f2re/hand-draw-esp/docs/START_HERE.md

# Полный маршрут: от закупки до первого рисунка

Эта инструкция задаёт обязательные шлюзы работ. Не переходите к следующему этапу, пока не выполнены критерии приёмки предыдущего. Конструкция рассчитана на MKS DLC32 V2.1, два NEMA17, TMC2209, ремни GT2, направляющие MGN12H и позиционный MG90S.

Проект находится на стадии инженерного прототипа. Программная часть проверяется автоматически; физическая механика должна быть подтверждена измерениями и контрольной сборкой.

## 0. Зафиксированная конфигурация

| Параметр | Значение |
|---|---|
| Управляемое поле | 225 × 315 мм |
| Лист | A4 210 × 297 мм, неподвижный, портретная установка |
| Ось Y | MGN12H 450 мм, две каретки, центры 52 мм |
| Ось X | профиль 2020 длиной 350 мм + MGN12H 300 мм |
| Передача | GT2 6 мм, шкивы 20T |
| Двигатели | 2 × одинаковых NEMA17, 1,8°, известный ток фазы |
| Контроллер | MKS DLC32 V2.1, ESP32-WROOM |
| Драйверы | одинаковые TMC2209 StepStick, автономный STEP/DIR |
| Подъём пера | MG90S 180°, виртуальная ось Z |
| Питание | 12 В / 5 А; отдельные 5,0 В для MG90S |

Изменение шкива, микрошагов, поля, направляющей, расстояния кареток или платы требует обновления CAD, повторной проверки и при необходимости изменения `firmware/fluidnc/config.yaml`.

Прямой альбомный лист не помещается по X=225 мм. Альбомное задание допускается только после реализации и проверки программного поворота траектории на портретно установленном листе.

## 1. Проверка GitHub-проекта

После получения или обновления репозитория:

```bash
python3 scripts/setup_project.py
npm test
```

CAD без OpenSCAD:

```bash
python3 scripts/validate_cad.py
```

При установленном OpenSCAD:

```bash
python3 scripts/validate_cad.py --strict --render-all
```

Критерий завершения:

- `npm test` завершается успешно;
- CAD-валидатор подтверждает физический ход;
- OpenSCAD компилирует сборку и все печатные детали;
- отсутствуют ошибки `assert`.

## 2. Шлюз A — закупка критичных деталей

Откройте [`hardware/BOM.md`](../hardware/BOM.md). На первом этапе заказываются только компоненты, определяющие геометрию и настройку приводов:

- MGN12H 450 мм с двумя каретками;
- MGN12H 300 мм с одной кареткой;
- профиль 2020 длиной 350 мм, паз 6;
- два одинаковых NEMA17 с паспортным током;
- три одинаковых TMC2209, включая запасной;
- два позиционных MG90S;
- шкивы, ролики, ремень и 625;
- одинаковые концевики COM/NO/NC;
- MKS DLC32 с зафиксированной подревизией.

Не заказывайте полный набор нестандартного крепежа и не печатайте весь пластик до измерения.

Критерий завершения:

- Y-рельс действительно имеет две каретки;
- двигатели одной модели;
- драйверы одной ревизии;
- MG90S позиционный, а не непрерывный;
- подревизия MKS DLC32 записана;
- критичные компоненты не имеют механических повреждений.

## 3. Шлюз B — измерение

1. Сделайте копию `hardware/measurements.example.csv` под именем `hardware/measurements.csv`.
2. Выполните [`hardware/MEASUREMENTS.md`](../hardware/MEASUREMENTS.md).
3. Зафиксируйте точные артикулы, номиналы и фактические размеры.
4. Перенесите принятые размеры в [`hardware/cad/component_dimensions.scad`](../hardware/cad/component_dimensions.scad).
5. Повторно запустите CAD-валидатор.

Обязательно измерить:

- длины и сетки отверстий MGN12H;
- положение крайних отверстий рельсов;
- профиль и T-гайки;
- NEMA17 и ток фазы;
- ревизию, Rsense и Vref TMC2209;
- корпус, уши и рог MG90S;
- ролики, шкивы и подшипник 625;
- концевики;
- ручку и пружину;
- отверстия конкретной платы MKS DLC32.

Критерий завершения:

- все строки критичных компонентов имеют статус;
- нет размеров, принятых только по названию карточки товара;
- `validate_cad.py` подтверждает ход не меньше 225 × 315 мм;
- режим `motion_envelope` не показывает очевидных столкновений.

## 4. Шлюз C — контрольная 3D-печать

Следуйте [`hardware/PRINTING.md`](../hardware/PRINTING.md). Сначала печатаются:

1. `fit_coupon`;
2. одно `beam_saddle`;
3. `pen_slider`;
4. тест корпуса пера;
5. один `belt_clamp`;
6. `servo_bracket`;
7. один `endstop`.

Критерии завершения:

- профиль входит рукой и фиксируется без раскалывания седла;
- ползун движется свободно без заметного качания;
- M3/M4/M5 соответствуют принятому зазору;
- ремень удерживается без повреждения корда;
- MG90S устанавливается без изгиба корпуса;
- концевик совпадает с фактическими отверстиями.

После корректировки параметров повторно выполнить OpenSCAD-компиляцию всех деталей.

## 5. Шлюз D — сухая механическая сборка

Выполняйте [`hardware/ASSEMBLY.md`](../hardware/ASSEMBLY.md):

1. плоское основание;
2. рельс Y и две каретки;
3. пластина Y;
4. два седла и балка 2020;
5. рельс X;
6. каретка пера;
7. опорный ролик свободного конца;
8. концевики;
9. проверка кабельных зон.

На этом этапе ремни и двигатели ещё не должны маскировать механическое закусывание.

Критерий завершения:

- обе оси проходят полный ход рукой;
- профиль остаётся перпендикулярным Y;
- два седла не изгибают профиль;
- опорный ролик только поддерживает балку;
- каретка пера не сталкивается с кронштейнами;
- лист и его зажимы находятся вне опасных траекторий.

## 6. Шлюз E — приводы

1. Установите осевые кронштейны X и Y; они не взаимозаменяемы.
2. Установите шкивы и ролики в одной плоскости.
3. Закрепите ремни согласованными зажимами с шагом 18 мм.
4. Натяните ремни только до исчезновения провиса.
5. Найдите пары обмоток двигателей мультиметром.
6. Установите микрошаг 1/16 по схеме конкретной ревизии TMC2209.
7. Рассчитайте начальный Vref по точной схеме драйвера и току двигателя.

Нельзя применять формулу Vref одной ревизии TMC2209 к неизвестному модулю.

Критерий завершения:

- ручное вращение валов не выявляет тугих зон;
- ремни не трутся о борта;
- шкивы закреплены на D-срезе;
- начальные значения тока документированы;
- радиаторы установлены.

## 7. Электрика

Используйте [`hardware/WIRING.md`](../hardware/WIRING.md) и [`docs/images/wiring.svg`](images/wiring.svg).

Порядок:

1. 12 В и USB отключены.
2. Проверена ориентация TMC2209.
3. DC/DC настроен мультиметром на 5,0 В без сервопривода.
4. Объединены GND платы, DC/DC и MG90S.
5. MG90S получает питание только от DC/DC.
6. Концевики подключены через COM+NC.
7. Предохранитель установлен возле входа 12 В.
8. Жгуты имеют разгрузку на полном ходе.

Критерий завершения:

- между +12 В и GND нет короткого замыкания;
- линия MG90S имеет 5,0 В без заметной просадки;
- провода промаркированы;
- доступно аппаратное отключение 12 В.

## 8. Первичная прошивка ESP32

Следуйте [`firmware/fluidnc/INSTALL.md`](../firmware/fluidnc/INSTALL.md). На первом этапе подключается только USB; 12 В, двигатели и MG90S отключены.

```bash
python3 scripts/install_fluidnc.py
python3 scripts/install_fluidnc.py --flash
```

Затем подготовьте проект:

```bash
python3 scripts/build_webui.py
python3 scripts/prepare_controller_bundle.py
```

Загрузите WebUI:

```bash
python3 scripts/deploy_webui.py handdraw.local
```

Конфигурацию передавайте отдельно и только после проверки платы:

```bash
python3 scripts/deploy_webui.py handdraw.local --with-config
```

После перезагрузки прочитайте полный журнал. Нельзя продолжать при сообщениях:

```text
Ignored key
Pin is already used
ERR
Guru Meditation
```

## 9. Первый пуск без ручки

1. Снимите 12 В.
2. Установите драйверы и подключите двигатели.
3. Отведите каретки от упоров.
4. Включите питание с готовностью немедленно его снять.
5. Проверьте `$Limits`, нажимая каждый концевик рукой.
6. Выполните перемещения X/Y по 1–5 мм.
7. Исправьте направление в конфигурации при снятом питании.
8. Запустите `gcode/servo_test.gcode` без пишущего инструмента.
9. Проверьте homing `$H` несколько раз.
10. Откройте WebUI с ESP32 и убедитесь, что состояние и координаты обновляются.

Критерий завершения:

- оси движутся в ожидаемом направлении;
- правильный концевик останавливает правильную ось;
- ни одна каретка не ударяется в упор;
- MG90S не упирается и не нагревается;
- двигатели и драйверы не перегреваются на малых перемещениях;
- WebUI определяет завершение homing в текущем сеансе.

## 10. Калибровка, профиль инструмента и первый рисунок

Следуйте [`docs/CALIBRATION.md`](CALIBRATION.md):

1. квадрат 100 × 100 мм;
2. измерение сторон;
3. измерение диагоналей;
4. устранение механического перекоса;
5. корректировка `steps_per_mm`;
6. повторный проход по линии;
7. рамка A4 с поднятым инструментом;
8. установка линера или шариковой ручки;
9. подбор пружины и крайних положений Z;
10. текстовый пресет «Аккуратная запись» и простой SVG.

Для первого рисунка используйте линер: это наиболее предсказуемый профиль. После успешного задания отдельно калибруйте гелевую ручку, карандаш, маркер и перо с тушью. Смена инструмента требует нового теста подъёма и обводки рамки.

Рабочий поток WebUI:

1. сформировать макет и устранить предупреждения;
2. выбрать профиль реального инструмента;
3. подключить FluidNC и выполнить homing;
4. выполнить тест пера и подтвердить результат;
5. закрепить лист;
6. обвести габарит с поднятым пером;
7. записать и проверить файл на SD;
8. запустить под постоянным наблюдением.

Подробно: [`docs/WEB_INTERFACE.md`](WEB_INTERFACE.md) и [`docs/FIRMWARE_AND_GCODE.md`](FIRMWARE_AND_GCODE.md).

Целевые критерии первой рабочей версии:

- сторона 100 мм: отклонение не более ±0,3 мм;
- разность диагоналей: не более 0,5 мм;
- повторная линия расходится не более чем на 0,3 мм;
- перо полностью отрывается;
- бумага не продавливается;
- отсутствуют пропуски шагов;
- после длительного задания температуры остаются допустимыми.

## 11. Финальная конфигурация безопасности

После устойчивого homing:

- включить обязательный homing перед заданиями;
- определить режим аппаратных ограничений;
- зафиксировать финальный Vref;
- сохранить итоговый `config.yaml`;
- приложить журнал загрузки;
- проверить аппаратное снятие 12 В.

Программная кнопка остановки не заменяет аппаратный разрыв питания.

## 12. Восстановление

При некорректной работе:

1. снять 12 В;
2. отключить двигатели и MG90S;
3. подключить только USB;
4. при необходимости выполнить штатный `erase`;
5. повторно установить FluidNC;
6. проверить чистую прошивку;
7. загрузить WebUI;
8. конфигурацию загрузить последней;
9. повторить ввод с первого пуска без ручки.

## Карта документации

- [`docs/CAD_REWORK_PLAN.md`](CAD_REWORK_PLAN.md) — план доведения механики;
- [`hardware/BOM.md`](../hardware/BOM.md) — закупочные шлюзы;
- [`hardware/MEASUREMENTS.md`](../hardware/MEASUREMENTS.md) — измерение;
- [`hardware/cad/README.md`](../hardware/cad/README.md) — CAD и экспорт;
- [`hardware/PRINTING.md`](../hardware/PRINTING.md) — 3D-печать;
- [`hardware/ASSEMBLY.md`](../hardware/ASSEMBLY.md) — механика;
- [`hardware/WIRING.md`](../hardware/WIRING.md) — электрика;
- [`firmware/fluidnc/INSTALL.md`](../firmware/fluidnc/INSTALL.md) — прошивка ESP32;
- [`docs/DEPLOYMENT.md`](DEPLOYMENT.md) — WebUI и конфигурация;
- [`docs/WEB_INTERFACE.md`](WEB_INTERFACE.md) — работа оператора;
- [`docs/FIRMWARE_AND_GCODE.md`](FIRMWARE_AND_GCODE.md) — генерация G-code и профили инструментов;
- [`docs/ART_DIRECTION.md`](ART_DIRECTION.md) — принципы интерфейса;
- [`docs/CALIBRATION.md`](CALIBRATION.md) — калибровка;
- [`docs/SAFETY.md`](SAFETY.md) — безопасность.

## Интерактивный ввод в эксплуатацию

После электрической проверки откройте [`COMMISSIONING.md`](COMMISSIONING.md), создайте профиль своего станка, опросите FluidNC, проверьте направления и концевики, затем рассчитайте steps/mm.
