f2re/hand-draw-esp/docs/FIRMWARE_AND_GCODE.md

# Прошивка, генерация G-code и профили инструментов

Проверенная версия FluidNC закреплена в `firmware/fluidnc/fluidnc-lock.json`. Установщик использует этот тег по умолчанию; `--latest` разрешён только как осознанная проверка нового выпуска.

## Может ли ESP32 генерировать G-code

Технически ESP32 способен сформировать простой G-code из заранее известных координат, короткого текста или параметрической фигуры. Однако обработка произвольного SVG, фотографии, штриховки и пользовательского шрифта на самом контроллере конкурировала бы с памятью, сетевым стеком и задачами реального времени.

В HandDraw ESP принят более надёжный вариант:

1. ESP32 хранит и раздаёт автономный WebUI.
2. JavaScript выполняется в браузере телефона или компьютера.
3. Браузер преобразует текст, SVG или растр в полилинии и G-code.
4. Готовый файл записывается на SD-карту ESP32.
5. FluidNC планирует движение и выполняет файл.

Поэтому система работает без облака и интернета, но тяжёлая геометрия не выполняется внутри задачи управления двигателями. Для пользователя это выглядит как единое устройство: страница открывается с контроллера и работает в его локальной сети или точке доступа.

Создание отдельной серверной прошивки-генератора не требуется и не входит в проект. Это позволило сохранить официальный FluidNC вместо собственного трудно поддерживаемого форка.

## Разделение ответственности

FluidNC отвечает за:

- STEP/DIR и планировщик движения;
- ограничения скорости и ускорения;
- homing и программные границы;
- RC-servo как ось Z;
- выполнение G-code с SD-карты;
- realtime-команды паузы, продолжения и сброса;
- HTTP, WebDAV и WebSocket.

WebUI отвечает за:

- раскладку однолинейного текста;
- воспроизводимую вариативность почерка;
- импорт SVG;
- контуры, одинарную и перекрёстную штриховку, комикс-режим;
- поворот альбомного макета в физически портретный лист;
- оптимизацию порядка штрихов;
- анализ длины линий, подъёмов пера и времени;
- подготовку и проверку файла перед запуском.

## Профили пишущих инструментов

Значения ниже являются безопасными стартовыми параметрами, а не универсальными физическими нормами. Они находятся ниже пределов осей в `config.yaml` и должны уточняться на конкретной механике и бумаге.

| Профиль | Рисование | Холостой ход | Контакт / подъём | Особенность |
|---|---:|---:|---:|---|
| Линер | 1200 мм/мин | 3600 мм/мин | 0,10 / 0,08 с | универсальный тонкий штрих |
| Гелевая ручка | 850 | 2800 | 0,16 / 0,12 с | меньше скорость из-за насыщенной пасты |
| Шариковая ручка | 1050 | 3400 | 0,08 / 0,06 с | умеренный нажим, универсальный режим |
| Карандаш | 760 | 2700 | 0,05 / 0,05 с | перекрёстная штриховка, допустим повтор |
| Перо с тушью | 520 | 2100 | 0,24 / 0,18 с | только направленные штрихи, короткие задания |
| Маркер | 650 | 2300 | 0,14 / 0,12 с | редкая штриховка, без плотной заливки |

Профиль задаёт:

- скорость линии и перехода;
- выдержку после опускания и подъёма;
- возможность разворачивать направление штриха при оптимизации;
- рекомендуемую длину непрерывной линии;
- режим и плотность растра;
- начальный текстовый пресет;
- толщину линии в предпросмотре.

### Что профиль не может задать программно

В принятом держателе MG90S только поднимает ползун. Нажим создаётся пружиной, массой ползунка и положением инструмента. Поэтому профиль не заменяет механическую настройку:

- линеру и перу нужен минимальный нажим;
- шариковой ручке обычно требуется больше;
- карандаш должен писать без изгиба балки и поломки грифеля;
- маркер не должен продавливать и пропитывать лист.

Значения `Z0` и `Z5` задают крайние положения механизма подъёма. После смены геометрически другого инструмента требуется выполнить тест пера.

## Направленное перо с тушью

Перо отличается от шариковой ручки:

- обратный ход может менять толщину, цепляться за бумагу или разбрызгивать тушь;
- слишком длинная линия может закончиться без туши;
- частые мелкие штрихи вызывают лишние касания;
- плотная штриховка деформирует бумагу.

Поэтому профиль пера:

- запрещает разворот штрихов при оптимизации;
- по умолчанию выбирает контуры;
- предупреждает о линии длиннее 120 мм;
- при повторном проходе поднимает перо, возвращается к началу и снова идёт вперёд;
- не предполагает автоматического макания.

## Структура G-code

Генератор использует:

```gcode
G21        ; миллиметры
G90        ; абсолютные координаты
G94        ; подача в мм/мин
G0 Z5      ; перо вверх
G1 X… Y… F… ; переход с ограниченной скоростью профиля
G0 Z0      ; перо вниз
G4 P…      ; выдержка контакта
G1 X… Y… F… ; рисование
```

Перед запуском проверяются:

- исходные координаты без подмены `NaN`/`Infinity` нулями;
- границы портретного A4;
- положение листа относительно машинного нуля и итоговое поле 225 × 315 мм;
- положительные скорости;
- корректный диапазон пера и попадание обоих положений в Z 0…5 мм;
- число точек и подъёмов;
- длительность;
- длинные и слишком короткие штрихи;
- особенности выбранного инструмента.

Имя задания транслитерируется в переносимый ASCII-вариант, чтобы избежать проблем файловой системы и команд `$SD/Run`.

### Координаты листа и станка

Геометрия текста, SVG и растра хранится в координатах листа. Перед выпуском G-code к ней добавляется положение физического листа относительно машинного нуля. Для центрированного A4 в поле 225 × 315 мм используются начальные значения:

```text
X = 7,5 мм
Y = 9,0 мм
```

Поля `Лист от нуля X/Y` находятся в диагностическом разделе WebUI. Проверочная рамка и основное задание используют одни и те же смещения. Если после установки углового упора значения отличаются, оператор вводит фактические размеры; интерфейс блокирует задание, выходящее за машинное поле.

### Очередь команд и запись на SD

Обычные команды отправляются по одной и считаются завершёнными только после ответа `ok`. `error`, `ALARM`, разрыв WebSocket или тайм-аут прекращают текущую последовательность. Realtime-команды `?`, `!`, `~` и `Ctrl-X` остаются вне очереди.

G-code сначала записывается во временный файл, читается обратно и сравнивается побайтово. Затем WebUI пытается завершить запись через WebDAV `MOVE`; если контроллер не поддерживает этот метод, выполняется проверенная запись итогового файла и удаление временного. Простое совпадение размера больше не считается достаточной проверкой.

## Логика безопасного запуска

WebUI не позволяет запустить задание, пока не выполнены этапы:

1. макет находится в пределах листа;
2. FluidNC подключён и находится в допустимом состоянии;
3. выполнен homing в текущем сеансе;
4. отправлен тест пера и оператор подтвердил результат;
5. подтверждено крепление бумаги;
6. выполнена обводка габарита с поднятым пером и оператор подтвердил отсутствие столкновений;
7. G-code записан на SD и прочитан обратно;
8. в последнем диалоге подтверждено наблюдение за станком.

Смена макета или профиля инструмента сбрасывает относящиеся к нему подтверждения.

## Конфигурация FluidNC

`firmware/fluidnc/config.yaml` содержит консервативные пределы:

| Ось | Максимальная скорость | Ускорение |
|---|---:|---:|
| X | 4800 мм/мин | 180 мм/с² |
| Y | 4200 мм/мин | 140 мм/с² |
| Z-servo | 240 мм/мин | 80 мм/с² |

Профили инструментов используют меньшие скорости. Пределы контроллера являются последней защитой от ошибочно завышенного значения в интерфейсе.

### Ввод в эксплуатацию и рабочий режим

В репозитории находятся два профиля:

- `config.yaml` — наладочный: `must_home: false`, `hard_limits: false`;
- `config-production.yaml` — рабочий: `must_home: true`, `hard_limits: true`.

Наладочный профиль позволяет проверить направления перемещениями 1–5 мм. WebUI всё равно не разрешает запуск файла без homing в текущем сеансе. Рабочий профиль устанавливается только после проверки полярности обоих NC-концевиков и нескольких устойчивых циклов `$H`; включать его вслепую нельзя.

## Ограничения

- браузер нельзя закрывать во время подготовки и наблюдения, однако уже запущенный SD-файл выполняется FluidNC независимо от страницы;
- программный `Стоп` не заменяет аппаратное отключение 12 В;
- профиль не определяет реальный нажим;
- оценка времени учитывает длины и выдержки, но не моделирует полностью разгон на каждом сегменте;
- для пера с тушью автоматическое пополнение туши не реализовано;
- сложный растр требует разрежения, иначе задание будет долгим и создаст тысячи подъёмов.

## Профиль конкретного станка

Файл `.handdraw-machine.json` отделяет параметры конкретной сборки от общих профилей ручки или пера. В нём хранятся геометрия листа, steps/mm, пределы Z, сведения о контроллере и аппаратные подтверждения. Профиль не переписывает YAML автоматически: после измерения оператор переносит экспортированный фрагмент в обе конфигурации и повторяет контрольный рисунок.
