f2re/hand-draw-esp/docs/WEB_INTERFACE.md

# Веб-интерфейс оператора

## Назначение

WebUI хранится на ESP32 и открывается в обычном браузере. Интернет и внешние сервисы не нужны. Телефон или компьютер выполняет геометрические расчёты, а FluidNC остаётся ответственным за движение.

Основной поток состоит из трёх этапов: **Макет → Инструмент → Станок**. Лист с предпросмотром остаётся рядом на широком экране и переносится ниже элементов управления на телефоне.

## 1. Макет

### Текст

Встроены пресеты:

- живой почерк;
- аккуратная запись;
- технический текст;
- комикс;
- карандашный эскиз;
- перо.

По умолчанию используется однолинейный рукописный вариант, построенный из нескольких воспроизводимых начертаний. При одинаковом тексте, параметрах и зерне результат повторяется.

Основные параметры — текст, шрифт, высота букв и выравнивание. Точная настройка скрыта в раскрываемом блоке и включает ширину, интервалы, масштаб строчных, наклон и небольшую вариативность положения.

### SVG

Поддерживаются `path`, линии, ломаные, многоугольники, прямоугольники, окружности, эллипсы и `use`. Итоговая геометрия сэмплируется средствами браузера и упрощается с заданным допуском.

SVG-текст следует предварительно преобразовать в кривые либо набрать во встроенном редакторе текста.

### Растровый рисунок

Доступны четыре режима:

- одинарная штриховка;
- перекрёстная штриховка;
- контуры;
- комикс — контур и разреженные тени.

Можно изменять порог темноты, шаг, угол, детализацию контура и инверсию. Перед обработкой большое изображение уменьшается до рабочего размера, чтобы телефон не создавал чрезмерное число точек.

### Лист

Физически лист A4 устанавливается портретно. Альбомный макет автоматически поворачивается в это поле. Независимые поля задаются в миллиметрах.

Макет хранится в координатах бумаги, а G-code формируется в координатах станка. В разделе «Ручное управление и диагностика» задаётся положение листа от машинного нуля: номинально X 7,5 и Y 9 мм для центрированного A4 в поле 225 × 315 мм. Эти же значения применяются к проверочной рамке.

Предпросмотр, проверка границ и G-code используют один массив полилиний. Красное состояние означает, что запуск недопустим.

## 2. Инструмент

Профили доступны одной группой выбора:

- линер;
- гелевая ручка;
- шариковая ручка;
- карандаш;
- перо с тушью;
- маркер или фломастер.

После выбора интерфейс подставляет скорость рисования, скорость перехода, выдержки пера, режим растра и подходящий характер текста. Рекомендация отображается рядом с параметрами.

Точные значения можно изменить, но интерфейс продолжает проверять диапазон пера и аномально тяжёлые задания. Смена инструмента сбрасывает тест пера, обводку рамки и загруженный файл: эти проверки относятся к конкретному физическому режиму.

Нажим не задаётся программой. MG90S поднимает ползун, а пружина создаёт контакт с бумагой.

## 3. Станок

### Подключение

При открытии страницы с ESP32 WebUI подключается к тому же адресу автоматически. При локальном просмотре можно вручную указать адрес контроллера.

Статус соединения и состояние FluidNC видны в верхней части страницы. Координаты и прогресс поступают через WebSocket.

### Обязательная проверка

Перед запуском интерфейс последовательно требует:

1. корректный макет;
2. соединение с FluidNC;
3. homing;
4. тест подъёма и опускания пера;
5. подтверждение крепления листа;
6. обводку габарита с поднятым пером;
7. запись задания на SD через временный файл с побайтовым сравнением результата.

Кнопка запуска остаётся недоступной, пока не выполнены все пункты. Последний диалог требует подтвердить присутствие рядом со станком и доступность аппаратного отключения питания.

### Во время выполнения

Доступны:

- пауза `!`;
- продолжение `~`;
- программный сброс `Ctrl-X`;
- координаты;
- текущая подача;
- имя SD-файла и процент выполнения;
- журнал сообщений.

Уход со страницы во время движения вызывает предупреждение. FluidNC продолжает уже запущенный файл с SD, но оператор теряет наблюдение через WebUI.

### Ручной режим

В раскрываемом разделе находятся:

- адрес контроллера;
- положение листа X/Y относительно машинного нуля;
- перемещения X/Y;
- расстояние и скорость jog;
- ручной подъём и опускание пера;
- снятие Alarm;
- технический журнал.

Ручные команды разрешены только при допустимом состоянии станка.

## Предпросмотр и анализ

На листе отображаются:

- линии с опущенным пером;
- опциональные холостые переходы;
- границы полей;
- курсор локальной симуляции;
- завершённые и текущие штрихи при выполнении.

Статистика включает:

- число штрихов и точек;
- длину рисования и переходов;
- число подъёмов;
- самый длинный непрерывный штрих;
- оценку времени;
- габариты.

Предупреждения учитывают выбранный инструмент: для пера анализируются направление и длина штрихов, для маркера — повторные проходы, для дробного растра — число подъёмов и точек.

## Редактор шрифта

Пользователь может нарисовать варианты отдельных знаков мышью или стилусом, указать ширину, автора и лицензию, затем сохранить шрифт в формате `.handdraw-font.json`.

Шрифты и параметры интерфейса хранятся в `localStorage` текущего браузера. Для переноса на другое устройство используется экспорт JSON.

## Клавиатура, мобильный экран и уменьшенное движение

- вкладки переключаются стрелками, `Home` и `End`;
- все действия доступны без hover;
- видимый фокус не удаляется;
- элементы управления имеют крупные зоны нажатия;
- проверяются ширины 320, 375, 414 и 768 пикселей;
- при `prefers-reduced-motion: reduce` декоративные переходы отключаются.

Автоматизированный сценарий: `tests/browser_smoke.py`.

## Профиль станка и первичная настройка

В разделе **Станок → Ручное управление и диагностика** можно создать профиль конкретного экземпляра. Он сохраняет смещение листа, steps/mm, диапазон Z, версию FluidNC и результаты аппаратного чек-листа.

Кнопка **Опросить контроллер** получает `$I`, активное имя конфигурации и состояние SD. **Проверить концевики 8 с** временно включает `$Limits`; за это время оператор поочерёдно нажимает X и Y.

После измерения линии 100 мм WebUI рассчитывает новые steps/mm и формирует YAML-фрагмент. Профиль экспортируется как `.handdraw-machine.json` и может быть восстановлен в другом браузере.

Рабочую `config-production.yaml` следует загружать только после появления статуса **Готов к рабочему профилю**. Полный порядок: [`COMMISSIONING.md`](COMMISSIONING.md).
