f2re/hand-draw-esp/docs/SAFETY.md

# Безопасность

## Электропитание

- Использовать закрытый сертифицированный адаптер 12 В, а не открытый сетевой блок.
- Установить предохранитель 5 А в провод +12 В как можно ближе к входу.
- Предусмотреть доступный выключатель питания; аппаратная аварийная кнопка предпочтительнее.
- До подключения MG90S выставить DC/DC на 5,0 В мультиметром.
- Объединить GND DC/DC, сервопривода и MKS DLC32.
- Не питать сервопривод от вывода 3,3 В ESP32.
- Не устанавливать и не снимать StepStick при поданном питании.

## Механика

- Закрыть или убрать длинные свободные волосы и одежду.
- Не держать пальцы между кареткой и упором.
- Проводка должна иметь запас на полный ход и не попадать под ролики.
- Магниты и зажимы листа не должны выступать в траекторию пера.

## Первый запуск

1. Снять ручку.
2. Ослабить ремни до умеренного натяжения.
3. Поставить каретки примерно в центр.
4. Подать питание с возможностью немедленного отключения.
5. Проверить нагрев драйверов и двигателя без движения.
6. Выполнять только перемещения 1–5 мм.
7. Проверить концевики вручную.
8. Выполнить homing.
9. Выполнить рамку с поднятым пером.
10. Только после этого установить ручку.

## Проверка WebUI перед заданием

Интерфейс блокирует запуск, пока не подтверждены:

- корректный макет;
- соединение с FluidNC;
- homing в текущем сеансе;
- тест подъёма пера;
- крепление листа;
- обводка габарита с поднятым пером;
- обратное чтение записанного SD-файла;
- присутствие оператора рядом со станком.

Эти проверки уменьшают риск ошибки оператора, но не являются аппаратной цепью безопасности. Подтверждение нельзя ставить заранее или переносить между разными инструментами.

## Программный останов

Кнопка «Стоп» отправляет realtime reset `Ctrl-X`. Она зависит от работающей электроники, Wi‑Fi и прошивки. При механическом зажиме, дыме, запахе или неконтролируемом движении отключить 12 В аппаратно.

## Задания

Перед запуском проверить:

- выбранный формат листа;
- поля;
- отсутствие выхода за лист;
- положение нуля;
- поднятие пера;
- достаточное свободное место;
- оценку времени;
- отсутствие людей рядом со станком.

Не оставлять самодельный станок без присмотра.

## Наладочная и рабочая конфигурации

`config.yaml` применяется только при вводе в эксплуатацию: он позволяет коротко проверить направления до homing и не включает hard limits. После проверки NC-концевиков и не менее трёх устойчивых циклов `$H` следует перейти на `config-production.yaml`, где включены `must_home: true` и `hard_limits: true`. Рабочий профиль не заменяет аппаратную кнопку снятия 12 В.
