f2re/hand-draw-esp/docs/ART_DIRECTION.md

# Арт-направление интерфейса HandDraw ESP

## Продуктовая основа

HandDraw ESP помогает превратить текст, векторный рисунок или растровое изображение в проверенное задание для реального пишущего плоттера и безопасно запустить его без облака.

Интерфейс относится к операционным инструментам. Его задача — не демонстрация возможностей проекта, а последовательная подготовка физического действия, которое нельзя мгновенно отменить после начала.

## Пользователь и условия

Основной пользователь собирает или эксплуатирует настольный плоттер самостоятельно. Он может открыть интерфейс с телефона рядом со станком либо с компьютера во время подготовки макета. Важны:

- понятный результат без знания G-code;
- минимальное число обязательных решений;
- доступ к точным параметрам без перегрузки первого экрана;
- предупреждения до движения механики;
- сохранение управления при ширине экрана от 320 пикселей;
- отсутствие зависимости от интернета.

## Выбранное направление

**Спокойная мастерская с листом в центре внимания.** Интерфейс использует материальные ассоциации бумаги, графита и чертёжного инструмента, но остаётся цифровым и операционным. Визуальная система близка по принципам к macOS и iOS: ясная иерархия, системная типографика, ограниченное число поверхностей, крупные зоны нажатия, предсказуемые состояния и отсутствие декоративного шума.

Это не буквальная имитация системных приложений Apple. Интерфейс сохраняет собственную предметную идентичность: траектория, лист, инструмент и проверка станка являются главными объектами.

## Характерный приём

Характер интерфейса формируют два связанных элемента:

1. **Постоянный лист-предпросмотр.** Он показывает именно те полилинии, из которых будет сформирован G-code, а не отдельную иллюстрацию.
2. **Профили пишущих инструментов.** Линер, гелевая и шариковая ручки, карандаш, перо с тушью и маркер представлены как реальные способы работы с разными ограничениями движения.

## Композиция

Основной поток разделён на три этапа:

1. **Макет** — источник, размещение и траектория.
2. **Инструмент** — режим движения и контакта с бумагой.
3. **Станок** — подключение, homing, физические проверки, запись и запуск.

Редактор шрифта и справка являются вторичными рабочими разделами. Они не конкурируют с основным потоком.

На широком экране панель управления и лист располагаются рядом. На телефоне управление идёт первым, а лист остаётся доступен ниже без горизонтальной прокрутки. Критические кнопки не прячутся в жесты и не зависят от hover.

## Типографика

Используется системный стек шрифтов. Роли:

- заголовки — короткие и спокойные;
- основной текст — инструкции и последствия действий;
- служебный текст — единицы, состояния и подсказки;
- числовые значения — компактные, но не декоративные.

В интерфейсных подписях не используются англоязычные термины, когда есть однозначный русский эквивалент. `G-code`, `SVG`, `FluidNC`, `homing` и `jog` сохраняются там, где это технические имена протоколов или режимов.

## Цветовые роли

- тёплый светлый фон — рабочее пространство;
- белая поверхность — лист и элементы ввода;
- графитовый текст — основная информация;
- приглушённый бирюзовый — выбор и безопасное действие;
- янтарный — предупреждение и необходимость проверки;
- красный — останов и недопустимое состояние.

Цвет не является единственным носителем статуса: состояния сопровождаются текстом, иконкой либо изменением доступности действия.

## Движение

Анимация применяется только для объяснения:

- переход между состояниями;
- ход локальной симуляции;
- прогресс реального задания;
- появление актуального предупреждения.

Длительные декоративные анимации отсутствуют. При `prefers-reduced-motion: reduce` переходы отключаются.

## Что сознательно исключено

- рекламная компоновка и крупные лозунги;
- сетка из одинаковых декоративных карточек;
- стеклянные панели, свечение и фоновые градиентные пятна;
- скрытый мастер, который не позволяет вернуться к предыдущему этапу;
- запуск одной кнопкой без homing, проверки пера и рамки;
- выдуманная точность и обещания качества, не подтверждённые физической сборкой.

## Доступность и проверка

Минимальные требования:

- все элементы управления доступны с клавиатуры;
- вкладки имеют семантику `tab`/`tabpanel` и управление стрелками;
- минимальная рабочая зона нажатия — 44 пикселя;
- видимый `:focus-visible`;
- состояния и ошибки объявляются через `aria-live`;
- нет горизонтального переполнения на 320, 375, 414 и 768 пикселях;
- поддерживается уменьшенное движение;
- запуск остаётся заблокированным, пока не завершены физические проверки.

Автоматическая браузерная проверка находится в `tests/browser_smoke.py`.
