f2re/hand-draw-esp/docs/CAD_REWORK_PLAN.md

# План устранения механических несогласованностей

## 1. Исходная проблема

Первоначальный `assembly` в OpenSCAD представлял собой несколько деталей, разложенных рядом. Он не проверял:

- совпадение отверстий;
- способ крепления профиля;
- установку двигателей и роликов;
- прохождение ремней;
- крайние положения;
- столкновения;
- действительный ход;
- положение листа;
- крепление MG90S и тяги;
- работу опорного ролика.

Поэтому успешная компиляция CSG не означала собираемость станка.

## 2. Целевое состояние

Механика считается готовой только при одновременном выполнении условий:

1. все покупные узлы представлены референсными габаритами;
2. каждая печатная деталь имеет однозначную ответную деталь;
3. размеры сопряжения задаются одной общей переменной;
4. имеется реальная сборка в единой системе координат;
5. показаны `home`, `center`, `max`;
6. расчётный физический ход превышает 225 × 315 мм;
7. OpenSCAD компилирует все детали отдельно;
8. измеренные размеры перенесены в параметры;
9. напечатаны контрольные посадки;
10. собран и измерен физический прототип.

## 3. Этапы и состояние

| Этап | Результат | Состояние |
|---|---|---|
| 0. Фиксация архитектуры | одна рельса Y, две каретки, поддерживаемая балка, портретный A4 | выполнено |
| 1. Сбор номинальных размеров | MGN12, MG90S, профиль, двигатель, TMC2209 | выполнено для проектирования |
| 2. Карта физических измерений | таблица, методы и критерии приёмки | выполнено |
| 3. Расчёт ходов | 238,6 мм X и 336,6 мм Y физически | выполнено |
| 4. Расчёт приводов | 80 шагов/мм; оценка момента и серво | выполнено как предварительная проверка |
| 5. Новая CAD-сборка | сопряжённые детали и референсные компоненты | реализовано |
| 6. Автоматическая проверка | статический валидатор и OpenSCAD-режим CI | реализовано |
| 7. Физические измерения | заполненный `measurements.csv` | ожидает купленных деталей |
| 8. Пробная печать | купоны, седло, ползун, зажим | ожидает принтера и деталей |
| 9. Сборка прототипа | ручное перемещение без клина | ожидает аппаратной сборки |
| 10. Приёмочные испытания | квадрат, диагонали, повтор, нагрев, длинный текст | ожидает прототипа |

## 4. Принятые инженерные решения

### 4.1. Расстояние между каретками Y

Прежнее значение 60 мм уменьшено до 52 мм. Для рельса 450 мм и каретки 45,4 мм:

```text
450 − (45,4 + 52) − 2×8 = 336,6 мм
```

Это сохраняет разнос кареток для подавления рыскания и даёт 21,6 мм общего резерва относительно управляемого хода 315 мм.

### 4.2. Ход X

Для рельса 300 мм:

```text
300 − 45,4 − 2×8 = 238,6 мм
```

После ограничения поля до 225 мм остаётся 13,6 мм общего резерва.

### 4.3. Рабочее поле

В текущей компактной механике поддерживается портретный A4. Начало управляемого поля:

```text
X = 97,5 мм
Y = 137,5 мм
```

Лист 210 × 297 мм располагается внутри поля с полями:

```text
X: 7,5 мм с каждой стороны
Y: 9 мм с каждой стороны
```

Альбомный A4 297 × 210 мм не помещается в физический ход X=225 мм без программного поворота задания. До реализации и проверки автоматического поворота интерфейс не должен обещать прямой альбомный режим.

### 4.4. Балка 2020

Для справочного момента инерции 0,72 см⁴ и длины 350 мм консервативная оценка консольного прогиба под нагрузкой 3 Н составляет около 0,086 мм. В рабочей конструкции свободный конец поддерживается роликом, поэтому реальный статический прогиб должен быть ниже. Расчёт является фильтром грубых ошибок, а не заменой измерения.

### 4.5. MG90S

Номинальный момент 1,8 кг·см при радиусе рога 10 мм соответствует идеальной силе около 17,7 Н. Целевой нажим пера — 1–3 Н. Запас достаточен, но серво используется только для подъёма; рабочий нажим создаёт пружина.

### 4.6. NEMA17 и GT2

Для шкива 20T радиус по делительной окружности:

```text
r = 20 × 2 / (2π) = 6,37 мм
```

Двигатель 42 Н·см имеет большой статический запас для лёгкой каретки. Практическое ограничение задают ток TMC2209, ускорение, трение, натяжение ремня и динамика, поэтому паспортный момент нельзя считать гарантией отсутствия пропусков.

## 5. Реализованные изменения CAD

- номиналы вынесены в `component_dimensions.scad`;
- создана общая система координат;
- добавлены основание, лист, рабочее поле, обе направляющие, блоки, профиль, двигатели, шкивы, ролики, ремни, серво и перо;
- добавлены крайние положения и разнесённая сборка;
- пластина Y расширена и получила два отдельных седла балки;
- введён согласованный четырёхточечный интерфейс каждого седла;
- разделены кронштейны двигателей и роликов X/Y;
- согласованы отверстия корпуса пера и каретки X;
- создан отдельный крепёж MG90S;
- согласованы зажимы ремней;
- опорный ролик перенесён на движущуюся балку;
- добавлены `assert` для ходов и размещения листа;
- сохранены временные алиасы старых имён деталей.

## 6. Поиск и фиксация размеров

Порядок поиска для каждого компонента:

1. официальный каталог изготовителя;
2. официальный STEP/PDF конкретного артикула;
3. схема платы или репозиторий изготовителя;
4. только затем карточка продавца;
5. после поставки — физическое измерение.

Если официальный и фактический размеры расходятся, CAD строится по фактическому максимуму корпуса и фактическим центрам отверстий.

## 7. Порядок практической реализации

### Шлюз A — закупка геометрически критичных деталей

Заказать только:

- MGN12H 450 мм с двумя каретками;
- MGN12H 300 мм;
- профиль 2020 slot 6 длиной 350 мм;
- два одинаковых NEMA17;
- два одинаковых TMC2209 плюс запасной;
- два MG90S;
- шкивы, ролики, 625;
- GT2;
- концевики;
- пружины;
- MKS DLC32 точной подревизии.

### Шлюз B — измерение

Заполнить `hardware/measurements.csv`, перенести принятые значения в `component_dimensions.scad`, затем запустить CAD-валидацию.

### Шлюз C — тестовые печати

Печатать в следующем порядке:

1. `fit_coupon`;
2. один `beam_saddle`;
3. `pen_slider` и короткий тест корпуса;
4. один `belt_clamp`;
5. `servo_bracket`;
6. кронштейн выбранного концевика.

### Шлюз D — сухая сборка

Без ремней и электрики:

- поставить рельсы;
- установить пластину Y и балку;
- вручную провести весь ход;
- установить каретку пера;
- проверить крайние положения;
- проверить, что ролик только поддерживает балку.

### Шлюз E — привод

- установить ремни без перетяжки;
- найти пары обмоток;
- установить микрошаг 1/16;
- задать начальный ток;
- выполнить перемещения 1–5 мм;
- проверить нагрев.

### Шлюз F — приёмка

- рамка с поднятым пером;
- квадрат 100 × 100 мм;
- диагонали;
- повторный проход;
- текст на всём A4;
- 60 минут непрерывной работы;
- температура двигателей и драйверов;
- отсутствие пропущенных шагов.

## 8. Критерий завершения

Разработка механики считается завершённой после публикации:

- заполненной обезличенной таблицы фактических размеров;
- итогового набора STL и исходного SCAD;
- фотографий сборки;
- фотографии проводки;
- результатов калибровки;
- температурного теста;
- видео полного задания A4;
- перечня фактически использованных артикулов;
- зафиксированной версии FluidNC и итогового `config.yaml`.
