f2re/hand-draw-esp/hardware/BOM.md

# Закупочный перечень и шлюзы закупки

Полная рабочая таблица проекта остаётся в `bom.csv`/`bom.json`. Этот документ задаёт критичные характеристики, без которых механическая модель и настройка приводов не воспроизводимы.

## 1. Закупать по этапам

### Этап A — детали, определяющие CAD

Сначала приобрести:

- MGN12H 450 мм с двумя каретками на одном рельсе;
- MGN12H 300 мм с одной кареткой;
- профиль 2020 длиной 350 мм, паз 6;
- два одинаковых NEMA17;
- три одинаковых TMC2209 StepStick;
- два позиционных MG90S 180°;
- три шкива GT2 20T/5 мм;
- три зубчатых ролика GT2/M5;
- четыре 625;
- два-три одинаковых концевика COM/NO/NC;
- ремень GT2 без стального корда;
- MKS DLC32 точной подревизии.

После поставки заполнить `hardware/measurements.csv`.

### Этап B — после пробных посадок

- PETG/PA для полного комплекта;
- термовставки;
- окончательный крепёж;
- пружины;
- кабель и разъёмы;
- T-гайки;
- корпусные детали.

### Этап C — после сухой сборки

- окончательный блок питания;
- DC/DC;
- предохранитель и держатель;
- выключатель/аварийное снятие питания;
- кабельная цепь либо выбранная система жгута;
- зажимы бумаги.

## 2. Зафиксированная механическая конфигурация

| Позиция | Количество | Требование |
|---|---:|---|
| MKS DLC32 V2.1 | 1 | ESP32-WROOM; съёмные StepStick; точная подревизия записана |
| TMC2209 | 3 | одна ревизия; стандартный StepStick; два рабочих + запасной |
| NEMA17 | 2 | одна модель; 42 × 42 мм; вал 5 мм; 1,8°; 38–40 мм; 40–45 Н·см; известный ток |
| MG90S | 2 | позиционный 180°, не continuous; один рабочий + запасной |
| MGN12H Y | 1 комплект | 450 мм, две каретки на одном рельсе |
| MGN12H X | 1 комплект | 300 мм, одна каретка |
| Профиль 2020 | 1 | 350 мм, паз 6, прямой |
| GT2 | около 2 м | шаг 2 мм, ширина 6 мм, стекловолоконный/арамидный корд |
| Шкив GT2 | 3 | 20T, вал 5 мм, два рабочих + запасной |
| Ролик GT2 | 3 | ось M5, два рабочих + запасной |
| 625 | 4 | 5 × 16 × 5 мм, один рабочий + запас |
| Концевик | 3 | одинаковые, COM/NO/NC, два рабочих + запасной |
| Основание | 1 | берёзовая фанера 420 × 500 × 12 мм, плоская |
| PETG | 1 кг | сухой; для проб и рабочего комплекта |

## 3. Эталон двигателя

Для фиксации расчётов выбран класс StepperOnline `17HE15-1504S`:

- 42 × 42 × 38 мм;
- 42 Н·см;
- 1,5 А/фаза;
- 1,8°;
- вал 5 мм;
- длина вала 23,5 мм.

Можно использовать аналог только при одновременном выполнении условий:

- известен точный артикул;
- известен ток фазы;
- известны габариты и чертёж;
- размеры перенесены в `component_dimensions.scad`;
- Vref рассчитан заново;
- два двигателя одинаковы.

## 4. TMC2209

Предпочтителен один конкретный производитель и одна ревизия для всех трёх модулей. Для FYSETC V3.0/3.1 опубликовано:

- `MS1=VIO`, `MS2=VIO` — 1/16;
- `Irms ≈ 0,71 × Vref`;
- `Vref ≈ 1,41 × Irms`;
- практическое ограничение платы SilentStepStick ниже предельного тока кристалла.

Нельзя применять эту формулу к безымянному модулю, пока не проверены его схема и Rsense.

В закупочной таблице должны быть отдельные поля:

- производитель;
- ревизия;
- Rsense;
- ссылка на схему;
- положение MS1/MS2;
- рассчитанный начальный Vref;
- итоговый Vref после испытаний.

## 5. MG90S

Оригинальный TowerPro имеет номинальный корпус 22,8 × 12,2 × 28,5 мм и ушное расстояние 32,5 мм. Рынок содержит большое количество клонов и непрерывных версий.

Критерии приёмки:

- возвращается в заданное положение;
- не вращается непрерывно;
- комплектный рог без трещин;
- корпус соответствует измерительной карте;
- редуктор не имеет чрезмерного люфта;
- ток не вызывает просадку отдельного DC/DC 5 В.

## 6. Питание

| Позиция | Требование |
|---|---|
| Адаптер | закрытый 12 В / 5 А, центр разъёма «+» либо винтовой выход с защитой |
| DC/DC | 12→5 В, не менее 3 А с кратковременным запасом для MG90S |
| Предохранитель | 5 А у входа 12 В; тип и держатель фиксируются в BOM |
| Выключатель | рассчитан на постоянный ток и фактическую нагрузку |
| Провода 12 В | AWG18 или эквивалент |
| Моторные жгуты | 4 × AWG22 или эквивалент |
| Серво 5 В | AWG22; короткий путь; общая земля |
| Сигналы | AWG26; маркировка обоих концов |

## 7. Крепёж

Предварительный комплект:

- M3×8 — 30;
- M3×12 — 30;
- M3×16 — 20;
- M3×25 — 10;
- гайки M3 самоконтрящиеся — 30;
- шайбы M3 — 60;
- M4×12 — 24;
- M4×20 — 16;
- гайки/шайбы M4 — 40;
- M5×12 — 20;
- M5×16 — 16;
- M5×25 — 10;
- T-гайки M5 для паза 6 — 20;
- гайки/шайбы M5 — 40;
- термовставки M3 — 30–40.

Окончательные длины определяются после пробной печати. Не заказывать крупную партию нестандартных винтов до сухой сборки.

## 8. Критерии закупочной готовности

BOM считается готовым к полной закупке, когда для каждой критичной позиции есть:

- точный артикул;
- продавец;
- фактическое наличие;
- цена и дата проверки;
- технический источник;
- измерительная строка;
- критерий приёмки;
- допустимый аналог;
- влияние аналога на CAD/прошивку.
