f2re/hand-draw-esp/hardware/PRINTING.md

# 3D-печать деталей

Параметрическая модель: [`cad/plotter_parts.scad`](cad/plotter_parts.scad). Все номиналы компонентов находятся в [`cad/component_dimensions.scad`](cad/component_dimensions.scad).

До печати рабочего комплекта необходимо выполнить карту размеров [`MEASUREMENTS.md`](MEASUREMENTS.md).

## 1. Обязательная проверка модели

Без установленного OpenSCAD:

```bash
python3 scripts/validate_cad.py
```

С установленным OpenSCAD:

```bash
python3 scripts/validate_cad.py --strict --render-all
```

Проверка должна подтвердить:

- X: физический ход не меньше 225 мм;
- Y: физический ход не меньше 315 мм;
- масштаб 80 шагов/мм при 1/16;
- наличие всех печатных модулей;
- успешную компиляцию каждого `part`.

## 2. Не печатать всё сразу

Первый этап:

1. `fit_coupon`;
2. один `beam_saddle`;
3. `pen_slider`;
4. короткий участок `pen_body` или полный корпус с черновыми режимами;
5. один `belt_clamp`;
6. `servo_bracket`;
7. один `endstop`.

После проверки размеров обновить `component_dimensions.scad` и только затем печатать остальной комплект.

## 3. Комплект деталей

| `part` | Деталь | Рабочее количество | Рекомендуемый запас |
|---|---|---:|---:|
| `y_carriage_plate` | пластина двух кареток Y | 1 | 0 |
| `beam_saddle` | седло балки 2020 | 2 | 1 |
| `x_carriage_plate` | пластина каретки X | 1 | 0 |
| `pen_body` | корпус направляющей пера | 1 | 0 |
| `pen_slider` | подвижная цанга | 1 | 1 |
| `pen_cap` | крышка пружины | 1 | 1 |
| `servo_bracket` | кронштейн MG90S | 1 | 1 |
| `y_motor_mount` | кронштейн двигателя Y | 1 | 0 |
| `y_idler_mount` | кронштейн ролика Y | 1 | 0 |
| `x_motor_mount` | кронштейн двигателя X | 1 | 0 |
| `x_idler_mount` | кронштейн ролика X | 1 | 0 |
| `belt_clamp` | зажим GT2 | 2 | 2 |
| `support_roller` | опора балки с 625 | 1 | 0 |
| `endstop` | кронштейн концевика | 2 | 1 |
| `cable_clip` | кабельная клипса | 6 | 2 |
| `fit_coupon` | купон посадок | минимум 1 | по необходимости |
| `electronics_base` | корпус платы | 1 | печатать после измерения платы |
| `electronics_lid` | крышка | 1 | печатать после измерения платы |

## 4. Режимы печати

| Деталь | Материал | Слой | Периметры | Заполнение | Поддержки |
|---|---|---:|---:|---:|---|
| Y-пластина | PETG/PA | 0,20 | 5–6 | 45% gyroid | нет |
| Седла балки | PETG/PA | 0,20 | 6 | 55% | нет |
| X-пластина | PETG/PA | 0,20 | 5–6 | 45% | нет |
| Корпус пера | PETG/PA | 0,16 | 5 | 45% | локально при необходимости |
| Ползун пера | PETG/PA | 0,16 | 4 | 40% | нет |
| Крышка | PETG | 0,20 | 4 | 40% | нет |
| Кронштейн серво | PETG/PA | 0,20 | 5 | 50% | локально |
| Моторные кронштейны | PETG/PA | 0,20 | 6 | 55% | локально по ориентации |
| Роликовые кронштейны | PETG/PA | 0,20 | 6 | 55% | нет/локально |
| Зажимы ремня | PETG/PA | 0,16 | 6 | 100% | нет |
| Опора 625 | PETG/PA | 0,20 | 6 | 55% | нет |
| Концевики | PETG | 0,20 | 4 | 40% | нет |
| Корпус электроники | PETG | 0,24 | 3–4 | 20% | нет |

Сопло 0,4 мм. PLA допустим только для посадочных проб. Для рабочего станка предпочтителен сухой PETG; нагруженные зажимы можно печатать из PA при отработанном процессе.

## 5. Ориентация

- `y_carriage_plate` — большой плоскостью на стол;
- `beam_saddle` — основанием на стол, канал профиля вверх;
- `x_carriage_plate` — большой плоскостью на стол;
- `pen_body` — вертикально осью направляющей вверх; brim при необходимости;
- `pen_slider` — вертикально;
- `pen_cap` — плоской стороной вниз;
- `servo_bracket` — монтажной полосой вниз либо с локальной поддержкой;
- `belt_clamp` — зубцами вверх;
- `support_roller` — монтажной площадкой вниз;
- моторные кронштейны — так, чтобы слои не раскрывались от натяжения ремня;
- корпус электроники — дном вниз.

Для силовых кронштейнов направление слоёв важнее экономии поддержек. Нагрузка от ремня не должна разрывать деталь поперёк слоёв.

## 6. Калибровка принтера

Перед посадочными деталями проверить:

- поток;
- горизонтальное расширение;
- точность 20, 40 и 100 мм;
- круглые отверстия M3/M4/M5;
- термовставки;
- мосты и нависания;
- усадку выбранного материала.

`fit_clearance = 0.30` — исходный односторонний зазор. Он не является универсальным значением для любого принтера.

## 7. Экспорт STL

В OpenSCAD:

1. установить `part`;
2. выполнить F6;
3. убедиться, что консоль не содержит ошибок `assert`;
4. экспортировать STL;
5. подписать файл версией параметров, например `y_carriage_plate-r2-mgn12h-actual.stl`.

Командная строка:

```bash
mkdir -p build/stl
openscad -o build/stl/beam_saddle.stl \
  -D 'part="beam_saddle"' \
  hardware/cad/plotter_parts.scad
```

## 8. Приёмка пробных деталей

### Седло балки

- профиль входит рукой;
- седло не трескается;
- T-гайки доступны;
- после затяжки профиль не поворачивается;
- два седла не создают перекоса.

### Ползун пера

- проходит без закусывания;
- не имеет заметного углового качания;
- ключ входит в паз;
- зажим удерживает ручку без овальности корпуса;
- ползун возвращается под действием пружины.

### Зажим GT2

- отверстия совпадают с обеими каретками;
- шаг зубьев не режет корд;
- ремень не вытягивается вручную из зажима.

### Кронштейн MG90S

- корпус входит без изгиба;
- уши не трескаются;
- рог проходит весь рабочий диапазон;
- тяга не касается корпуса пера.

## 9. Корпус электроники

`electronics_base` остаётся предварительным до фиксации подревизии MKS DLC32 и координат отверстий. Печатать корпус до заполнения раздела MKS в `measurements.csv` запрещено.
