f2re/hand-draw-esp/hardware/ASSEMBLY.md

# Механическая сборка

Эта инструкция относится к переработанной параметрической сборке из `hardware/cad/plotter_parts.scad`.

## 1. Система координат

- X — поперёк основания 420 мм;
- Y — вдоль основания 500 мм;
- Z — вверх;
- ноль станка расположен у минимальных X/Y;
- лист A4 установлен портретно и неподвижен.

Расчётное управляемое поле: 225 × 315 мм. При номинальных деталях его начало находится примерно в точке:

```text
X = 97,5 мм
Y = 137,5 мм
```

Лист A4 210 × 297 мм располагается с началом:

```text
X = 105 мм
Y = 146,5 мм
```

Эти координаты уточняются после фактического измерения кареток, концевиков и держателя пера.

## 2. Инструмент

- штангенциркуль;
- угольник;
- линейка 500 мм;
- сверлильный инструмент;
- керн или перенос центров через рельс;
- шестигранники;
- отвёртки;
- мультиметр;
- кримпер;
- НШВИ;
- слабый фиксатор резьбы, опционально.

## 3. До сверления

1. Заполнить `hardware/measurements.csv`.
2. Перенести размеры в `component_dimensions.scad`.
3. Запустить `python3 scripts/validate_cad.py`.
4. Открыть `part="motion_envelope"` и проверить крайние положения.
5. Напечатать и принять пробные детали.
6. Разложить реальные рельсы, профиль, двигатели и лист на основании.

Отверстия рельсов переносить по фактическим деталям. Номинальный шаг 25 мм не задаёт расстояние от торца до первого отверстия конкретного отрезка.

## 4. Основание

Использовать плоскую фанеру 420 × 500 × 12 мм. Допустимо 10–12 мм при соответствующей длине крепежа.

Проверить:

- отсутствие винта;
- диагонали;
- плоскость в зоне листа;
- отсутствие качания на четырёх ножках.

Разметочные ориентиры:

| Элемент | Номинальное положение |
|---|---|
| ось рельса Y | X = 45 мм |
| начало рельса Y | Y = 25 мм |
| центр двигателя Y | Y = 10 мм |
| центр ролика Y | Y = 480 мм |
| линия ремня Y | около X = 25 мм |

Двигатель и кронштейн располагаются у нижнего края так, чтобы корпус не пересекал управляемое положение пластины Y.

## 5. Рельс Y

1. Очистить и смазать направляющую совместимой смазкой.
2. Не снимать каретки без транспортировочной вставки.
3. Поставить рельс по оси X=45 мм.
4. Слегка затянуть центральные винты.
5. Несколько раз провести обе каретки.
6. Последовательно затянуть остальные винты.
7. Проверить свободный ход.

Центры двух кареток в пластине разнесены на 52 мм. Пластину устанавливать так, чтобы обе сетки 20 × 20 мм совпали без принудительного изгиба.

## 6. Пластина Y и седла балки

1. Установить `y_carriage_plate` на две каретки.
2. Не затягивать один угол, если отверстия не совпадают: исправить CAD или посадку.
3. Установить два `beam_saddle` на сетки 14 × 32 мм.
4. Вставить профиль 2020 длиной 350 мм.
5. Расположить начало профиля примерно в X=35 мм.
6. Выставить профиль перпендикулярно Y.
7. Подтянуть боковые M5 через T-гайки без деформации профиля.

Два седла должны задавать одну прямую. Если профиль закусывает, проверить высоту седел и плоскость Y-пластины, а не затягивать силой.

## 7. Рельс X

Номинально рельс 300 мм начинается через 25 мм от левого торца профиля, то есть около глобального X=60 мм.

1. Разметить центр боковой поверхности профиля.
2. Установить рельс без перекоса.
3. Затягивать от центра к краям, перемещая каретку.
4. Проверить физический ход.
5. Убедиться, что каретка и печатная пластина не касаются двигателя и ролика в управляемых крайних положениях.

Расчётный физический ход одной MGN12H на рельсе 300 мм с торцевыми зазорами 8 мм — 238,6 мм. Управляемый ход ограничен 225 мм.

## 8. Привод Y

1. Установить `y_motor_mount` у нижнего края.
2. Вал двигателя должен быть перпендикулярен плоскости ремня.
3. Установить шкив 20T, один винт на плоскость D-среза.
4. Установить `y_idler_mount` и ролик у верхнего края.
5. Выставить шкив и ролик в одной плоскости.
6. Провести две ветви ремня параллельно рельсу.
7. Закрепить ремень на пластине штатным `belt_clamp` с шагом 18 мм.
8. Убрать провисание без гитарного натяжения.

## 9. Привод X

1. Установить `x_motor_mount` слева от рабочей зоны.
2. Установить `x_idler_mount` справа.
3. Выставить оси шкива и ролика параллельно Y.
4. Провести ремень по передней стороне балки.
5. Закрепить его на `x_carriage_plate` тем же зажимом 18 мм.
6. Проверить, что ремень не касается рельса, профиля и проводов.

Кронштейны X и Y не взаимозаменяемы.

## 10. Каретка пера

1. Установить `x_carriage_plate` на MGN12H четырьмя винтами M3.
2. Установить `pen_body` четырьмя M4 на согласованную сетку 32 × 40 мм.
3. Вставить `pen_slider`.
4. Установить пружину и `pen_cap`.
5. Проверить свободный ход 5 мм.
6. Установить `servo_bracket` на отдельную двухточечную сетку.
7. Установить MG90S без изгиба ушей.
8. Подобрать отверстие рога и длину тяги.

Сервопривод поднимает ползун. Нажим вниз создаётся только пружиной.

## 11. Опорный ролик

`support_roller` устанавливается на движущуюся балку возле правого конца. Подшипник 625 катится по основанию.

Регулировка:

1. полностью ослабить ролик;
2. выставить геометрию по единственному рельсу Y;
3. подвести подшипник до касания;
4. добавить минимальный преднатяг;
5. провести балку по всему ходу;
6. убедиться, что ролик не поднимает и не разворачивает балку.

Ролик не является второй направляющей и не должен задавать траекторию.

## 12. Концевики

Кронштейны являются параметрическими под выбранный переключатель. Фактическое положение определить по рычагу.

Требования:

- срабатывание за 2–5 мм до жёсткого упора;
- после щелчка остаётся ход;
- корпус переключателя не используется как упор;
- провод не натягивается;
- X и Y физически различимы маркировкой.

## 13. Кабели

- двигатель X, MG90S и концевик X идут в движущемся жгуте;
- петля рассчитана на весь Y-ход;
- провод MG90S по возможности отделён от моторных фаз;
- жгут не касается листа;
- на обоих концах есть разгрузка;
- в крайних положениях отсутствует натяжение.

## 14. Сухая приёмка

До установки ремней:

- каретки проходят полный ход одной рукой;
- балка остаётся перпендикулярной;
- профиль не качается в седлах;
- опорный ролик не клинит;
- перо движется вертикально;
- крайние положения не дают столкновений;
- лист и зажимы не пересекаются с пером.

После установки ремней:

- обе ветви каждой оси лежат в одной плоскости;
- ремень не трётся о борта;
- шкивы не гуляют;
- при ручном вращении моторного вала нет тугих зон.

## 15. Альбомный лист

Физический ход X составляет 225 мм, поэтому прямое размещение листа 297 мм по X не допускается. Альбомное задание возможно только после программного поворота траектории на 90° в портретном физическом поле. До проверки этого режима использовать только портретный A4.
