f2re/hand-draw-esp/CHANGELOG.md

# Журнал изменений

## 1.3.0

- добавлены сохраняемые и переносимые профили конкретного станка;
- WebUI получил мастер первичной настройки с опросом FluidNC, проверкой концевиков и аппаратным чек-листом;
- реализован расчёт скорректированных steps/mm и экспорт YAML-фрагмента;
- версия FluidNC закреплена через `fluidnc-lock.json`; использование `latest` теперь только явное;
- выпускной комплект содержит lock-файл, наладочную и рабочую конфигурации;
- расширена документация ввода станка в эксплуатацию.

## 1.2.0

- координаты страницы отделены от машинных координат; добавлены смещения листа X/Y и проверка поля 225 × 315 мм;
- холостые XY-переходы переведены с быстрого `G0` на управляемый `G1 F`, поэтому скорость профиля теперь реально применяется;
- добавлена строгая проверка `NaN`/`Infinity` и диапазона сервопривода Z 0…5 мм;
- команды FluidNC выполняются через очередь с ожиданием `ok/error`, тайм-аутами и отменой последовательности при ошибке;
- загрузка G-code выполняется через временный файл, побайтовую проверку и `MOVE` с безопасным резервным сценарием;
- SVG очищается по белому списку элементов и атрибутов до помещения в DOM;
- добавлен рабочий профиль `config-production.yaml` с обязательным homing и аппаратными пределами;
- комплект контроллера теперь содержит наладочную и рабочую конфигурации.

## 1.1.0

- полностью переработан операционный интерфейс по потоку «Макет → Инструмент → Станок»;
- добавлены профили линера, гелевой и шариковой ручек, карандаша, пера с тушью и маркера;
- добавлены пресеты живого почерка, технического текста, комикса, эскиза и пера;
- реализованы произвольный угол штриховки, перекрёстная штриховка и комикс-режим растра;
- добавлены отдельные выдержки подъёма/опускания, повторные проходы и сохранение направления пера;
- добавлен анализ длинных штрихов, дробных заданий, числа подъёмов и особенностей инструмента;
- запуск заблокирован до homing, теста пера, проверки листа, обводки рамки и подтверждённой записи на SD;
- запись G-code проверяется обратным чтением, а имя файла приводится к переносимому ASCII-варианту;
- интерфейс адаптирован для 320–768 пикселей, клавиатуры и `prefers-reduced-motion`;
- снижены предельные скорости и ускорения FluidNC до консервативных стартовых значений;
- добавлены документы по арт-направлению, архитектуре G-code и профилям инструментов;
- расширены модульные и браузерные тесты.

## 1.0.0

- добавлена полная конфигурация FluidNC для MKS DLC32 V2.1;
- реализован автономный WebUI для текста, пользовательских шрифтов, SVG и растровых изображений;
- добавлены предпросмотр, симуляция, оценка времени и управление заданием;
- добавлены параметрические детали OpenSCAD;
- подготовлены закупочный перечень, электрическая и механическая документация;
- добавлены сценарии настройки, сборки WebUI, формирования комплекта контроллера и сетевого развёртывания;
- добавлен помощник получения и запуска официального установщика FluidNC с фиксацией SHA-256;
- добавлены CI-артефакт контроллера и выпуск ZIP-комплекта по Git-тегу;
- добавлена единая инструкция `docs/START_HERE.md` от закупки до первого рисунка;
- добавлены автоматические проверки вычислительного ядра, структуры репозитория и браузерный smoke-тест.
