f2re/hand-draw-esp/(commit log)

2026-07-31 feat: publish complete HandDraw ESP project
    [config.yaml, plotter_parts.scad]
2026-07-31 feat: rebuild parameterized plotter mechanics
    Unify the A4 plotter into a dimension-driven OpenSCAD assembly, publish measurable component interfaces, restore unpacked WebUI/BOM sources, add CAD calculations and strict OpenSCAD CI, and update procurement, printing and assembly documentation.
    [bom.csv, component_dimensions.scad, measurements.example.csv, plotter_parts.scad]
2026-08-01 feat: redesign operator experience and media-aware motion
    Rebuild the operator experience around the Maket → Instrument → Machine flow; add tool-aware motion profiles for pens, pencil, ink nib and marker; extend handwriting, hatching, comic and raster processing; harden G-code generation, SD verification and FluidNC safety gates; add browser, module and OpenSCAD validation.
    [config.yaml]
2026-08-02 feat: harden coordinates, motion and FluidNC transport
    Unify page and machine coordinates, enforce feed-controlled XY travel and Z limits, add strict path validation, serialize FluidNC commands, verify SD files byte-for-byte, sanitize SVG input, add production configuration, and make deployment recoverable.
    [config-production.yaml]
2026-08-02 feat: add commissioning profiles and pin FluidNC
    Add per-machine commissioning profiles, controller diagnostics, limit and homing checklists, steps/mm calibration, generated commissioning/production configurations, a pinned FluidNC release lock, and updated deployment documentation. Remove temporary commissioning import infrastructure.
